vdask/Smart-Car-IoT-Project/ML_model/class_esp/class_esp.ino

#include "arduinoFFT.h"
#include "model.h"
#include <math.h>

#define MIC 34
#define SOUND_THRESHOLD 20
#define NUM_SAMPLES 512
#define SAMPLING_FREQUENCY 44100

float backgroundSound = 0;

double vReal[NUM_SAMPLES];
double vImag[NUM_SAMPLES];
float vRealHALF[NUM_SAMPLES/2];  // classification vector

unsigned int sampling_period;
unsigned long microseconds;

arduinoFFT fft;

// type of classifier we use
Eloquent::ML::Port::SVM classifier;

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
    return  (analogRead(MIC) - NUM_SAMPLES) >> 2;
}

void calibrate() {
    for (int i = 0; i < 10000; i++)
        backgroundSound += readMic();

    backgroundSound /= 10000;
}

bool soundDetected() {
    return abs(readMic() - backgroundSound) >= SOUND_THRESHOLD;
}

void captureWord() {
    for (uint16_t i = 0; i < NUM_SAMPLES; i++) {
        microseconds = micros();    //Overflows after around 70 minutes!
      
        vReal[i] = readMic();
        vImag[i] = 0;
        
        while (micros() < (microseconds + sampling_period)) {
        }
    }
    
    fft.Windowing(vReal, NUM_SAMPLES, FFT_WIN_TYP_HAMMING, FFT_FORWARD);
    fft.Compute(vReal, vImag, NUM_SAMPLES, FFT_FORWARD);
    fft.ComplexToMagnitude(vReal, vImag, NUM_SAMPLES);

    for (int i = 1; i <= NUM_SAMPLES / 2; i++) //except for the half and the first element
    {
        //Convert feature vectors to float values, since the classification model takes float as an argument
        vRealHALF[i - 1] = static_cast<float>(vReal[i]);
    }
}

void classify() {
    

    float similarity_bike = cosineSimilarity(vRealHALF, mean_bike);
    float similarity_car = cosineSimilarity(vRealHALF, mean_car);

    if((similarity_bike > 0.8) || (similarity_car > 0.80)){
      Serial.print("Predicted class: ");
      Serial.println(classifier.predictLabel(vRealHALF));
      Serial.print("Bike similarity : ");
      Serial.println(similarity_bike);
      Serial.print("Car similarity: ");
      Serial.println(similarity_car);
      Serial1.println("============================================= ");
    }

    else{
      Serial.print("There are no bikes or cars around.");
      Serial.println(classifier.predictLabel(vRealHALF));
      Serial.print("Bike similarity : ");
      Serial.println(similarity_bike);
      Serial.print("Car similarity: ");
      Serial.println(similarity_car);
      Serial1.println("============================================= ");
    }
}

float dotProduct(float v1[], float v2[]) {
  float sum = 0;
  for (int i = 0; i < NUM_SAMPLES / 2; i++) {
    sum += v1[i] * v2[i];
  }
  return sum;
}

float magnitude(float v[]) {
  float sum = 0;
  for (int i = 0; i < NUM_SAMPLES / 2; i++) {
    sum += v[i] * v[i];
  }
  return sqrt(sum);
}

float cosineSimilarity(float v1[], float v2[]) {
  return dotProduct(v1, v2) / (magnitude(v1) * magnitude(v2));
}
