vdask/Smart-Car-IoT-Project/ML_model/class_esp/model.h

#pragma once
#include <cstdarg>
namespace Eloquent {
    namespace ML {
        namespace Port {
            class SVM {
                public:
                    /**
                    * Predict class for features vector
                    */
                    int predict(float *x) {
                        float kernels[7] = { 0 };
                        float decisions[1] = { 0 };
                        int votes[2] = { 0 };
                        kernels[0] = compute_kernel(x,   1.62994513513  , 0.498456910707  , -0.327586767901  , 0.774768122883  , 1.355268990393  , 0.660652042881  , 0.039944723318  , -0.695421357822  , 0.515839815255  , -0.346287041647  , 1.31108380767  , 1.132679433757  , 0.910530737914  , 0.490589980397  , 1.185383704114  , 1.202731777823  , 0.921406289598  , 0.496990578372  , 1.062795729838  , 0.915217888832  , 0.940612385443  , 1.286830571261  , 0.368050056427  , 1.319619874521  , 1.141774696925  , 0.98784070625  , -0.717810395184  , 0.438320938393  , 0.811917975672  , 1.998132867644  , 2.966058734821  , 2.127418575553  , 1.055278180549  , 0.892733038178  , 0.389865286466  , 0.509439124493  , 1.44786579236  , 0.794507037303  , 1.228126641905  , 0.520106553306  , 0.589165676804  , 1.228732786552  , 0.40174370576  , -0.884461715839  , -0.802950208771  , 2.103003019172  , 1.482675761496  , 0.771601468167  , 0.787666511805  , 0.712916571021  , 1.075883262966  , 2.087083865534  , -0.470546245384  , -1.081097387031  , -1.093637095156  , 1.421934718915  , 1.067358821292  , -0.426085957176  , 2.106888693688  , 1.264565175497  , -0.577072436799  , 0.035993720918  , -0.559712955333  , 0.964454600936  , -0.481047456421  , -1.100951964215  , 0.540558392002  , 1.220719848191  , 1.005243000079  , -0.489743101113  , -0.67829080364  , -0.42433217891  , -0.491721577655  , 0.542252175367  , 0.536796086845  , 0.119689300686  , 0.950666407591  , -0.596981355287  , 1.384054763262  , -1.904707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
                    }

                    /**
                    * Predict readable class name
                    */
                    const char* predictLabel(float *x) {
                        return idxToLabel(predict(x));
                    }

                    /**
                    * Convert class idx to readable name
                    */
                    const char* idxToLabel(uint8_t classIdx) {
                        switch (classIdx) {
                            case 0:
                            return "Bike";
                            case 1:
                            return "Car";
                            default:
                            return "Houston we have a problem";
                        }
                    }

                protected:
                    /**
                    * Compute kernel between feature vector and support vector.
                    * Kernel type: linear
                    */
                    float compute_kernel(float *x, ...) {
                        va_list w;
                        va_start(w, 256);
                        float kernel = 0.0;

                        for (uint16_t i = 0; i < 256; i++) {
                            kernel += x[i] * va_arg(w, double);
                        }

                        return kernel;
                    }
                };
            }
        }
    }
